LPY9970/VLC_FPGA_Project/05_data/02_Ref_and_Measured/Oscilloscope_Waveforms.jpg

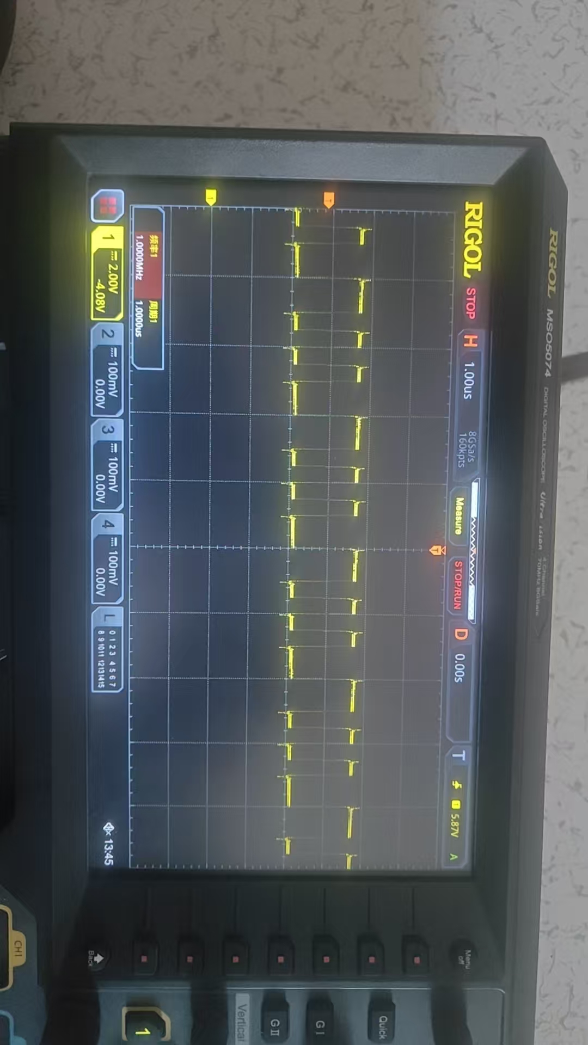
05_data/02_Ref_and_Measured/Oscilloscope_Waveforms.jpg
