LPY9970/VLC_FPGA_Project/05_data/02_Ref_and_Measured/Serial_Output_Photos.jpg

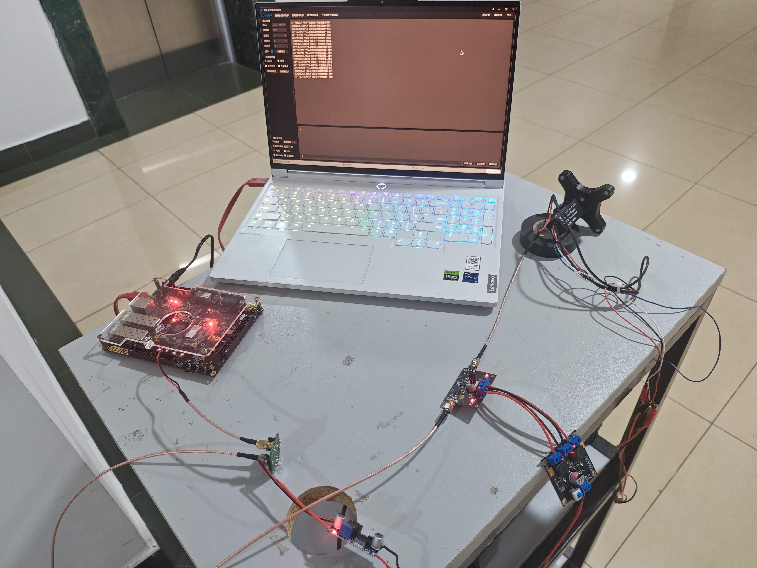
05_data/02_Ref_and_Measured/Serial_Output_Photos.jpg
