LPY9970/VLC_FPGA_Project/05_data/README.md

# 测试数据与参考结果验证报告 (VLC 光通信系统)

## 一、 测试目的
验证 VLC 空间光通信系统的完整链路（PC-UART -> PWM调制 -> 光发射 -> 20m空间光路 -> 光接收 -> PWM解调 -> UART-PC）的稳定性与正确性，并验证数据在长距离传输下是否发生丢包或误码。

## 二、 测试环境与数据
*   **物理环境**：20米自由空间光通信链路（使用透镜聚光与激光发射模块，见实物图）。
*   **上位机端**：PC 机，串口助手软件（波特率 9600, 8-N-1）。
*   **输入激励**：通过 PC 端串口发送 38 字节文本 “2017至2026 FPGA创新设计竞赛国赛十周年”。
*   **数据编码**：文本采用 GBK 编码（如 '2' 为 `0x32`，'0' 为 `0x30`）。
*   **物理层数据率**：1 Mbps。
*   **物理层编码**：采用 **PWM（脉宽调制）**。每 bit 周期固定为 1us，通过高电平脉宽区分数据：
    *   逻辑 `1`：高脉冲宽约 500ns（占空比 50%）。
    *   逻辑 `0`：高脉冲宽约 240ns（占空比 24%）。

## 三、 参考结果 (Reference Results)
根据系统设计逻辑，应输出以下参考结果：
1.  **发射端波形参考**：在 FPGA 的 `K14` 引脚，示波器应捕获到周期严格为 1us 的方波序列，且能清晰观察到宽脉冲（500ns）与窄脉冲（240ns）交替。
2.  **接收端输出参考**：在 PC 端串口助手上，应完整显示输入的那段 38 字节文本，不可出现乱码、丢字或卡死。

## 四、 实测结果与参考比对 (Measured vs. Reference)

### 1. 波形比对 (物理层验证)
*   **实测现象**：见 `board/01_Test_Output/Waveforms/Oscilloscope_PWM_Wave.png`。
*   **结果分析**：示波器实测周期为 **1.0000MHz**（即 1us），波形清晰展示了不同宽度的高脉冲。实测脉宽与理论设计的 500ns/240ns 高度吻合，证明 1Mbps PWM 调制逻辑完全正常。

### 2. 物理环境实测 (系统级验证)
*   **实测现象**：见 `board/01_Test_Output/Environment/Hardware_Setup_20m_Test.jpg`。
*   **结果分析**：系统在 20 米物理空间光路下成功建立连接，接收端光模块成功将光信号转化为电信号并正确解调。

### 3. 数据比对 (应用层验证)
*   **实测现象**：见 `board/01_Test_Output/Serial_Logs/Serial_Output_Verify.png`。
*   **结果分析**：PC 端串口助手成功、连续地复现了整段中文文本，与原始输入数据（`data/input_text.txt`）经人工与机器双重比对，完全一致，误码率为 0。

### 4. 极限吞吐测试 (压力测试)
*   **测试方法**：将发送端光信号回环短接至接收端（或保持 20m 光路），连续发送 100,000 字节。
*   **结果分析**：长时间运行下，接收端 FIFO 水位稳定，未发生溢出，实测丢包率为 **0%**，证明系统收发速率匹配（9600bps 串口收发）且逻辑稳定可靠。

## 五、 结论
系统的 PWM 调制解调逻辑正确，在 20m 物理光路下传输稳定。测试数据与参考结果完全一致，无丢包、无误码，满足了比赛/项目的设计要求。
