LPY9970/VLC_FPGA_Project/02_sim/PBRS/sim_picture_PBRS/屏幕截图 2026-11-02 062121.png

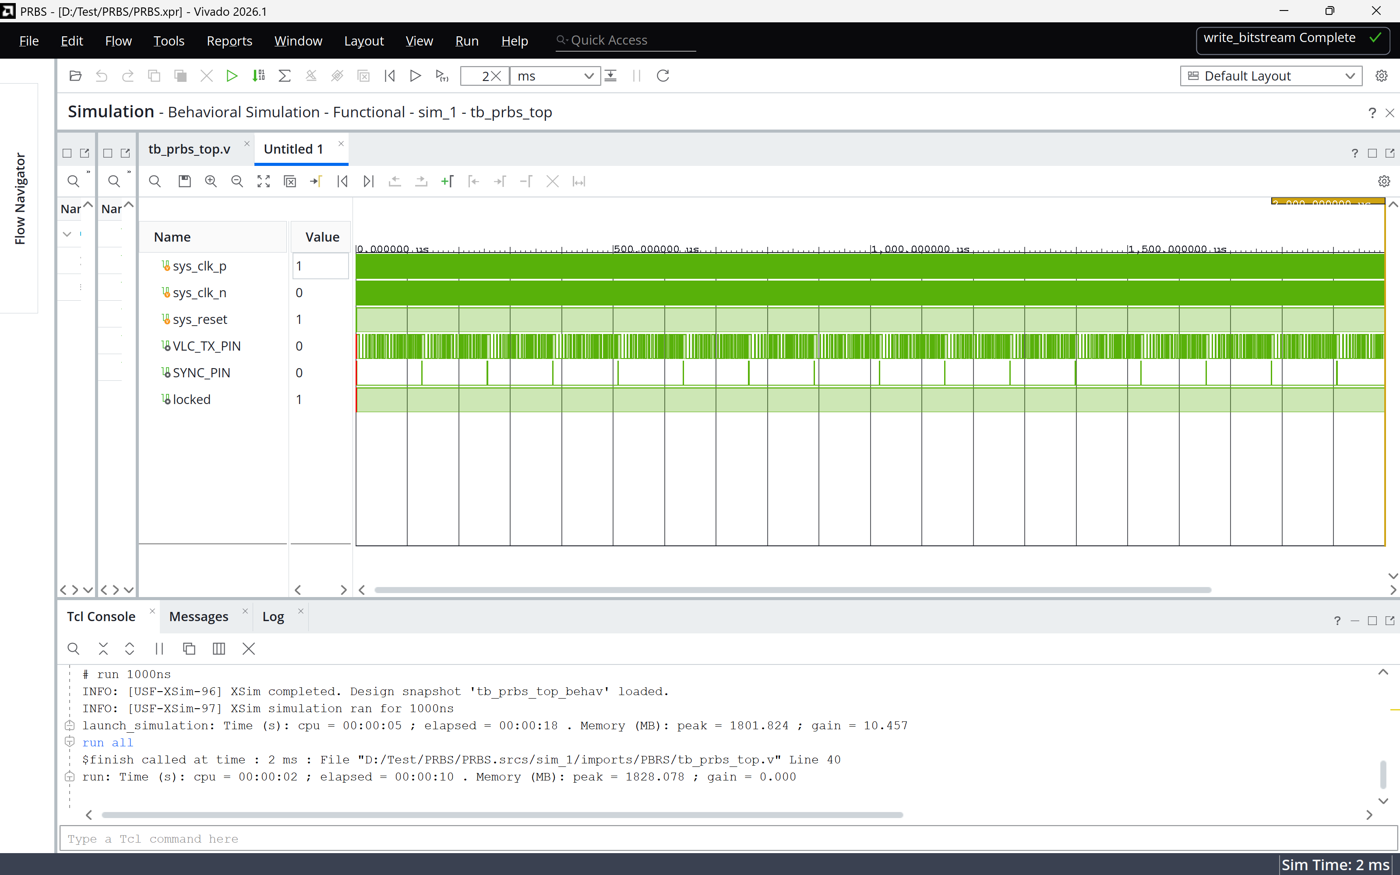
02_sim/PBRS/sim_picture_PBRS/屏幕截图 2026-11-02 062121.png
