LPY9970/VLC_FPGA_Project/02_sim/PBRS/sim_picture_PBRS/屏幕截图 2026-11-03 035135.png

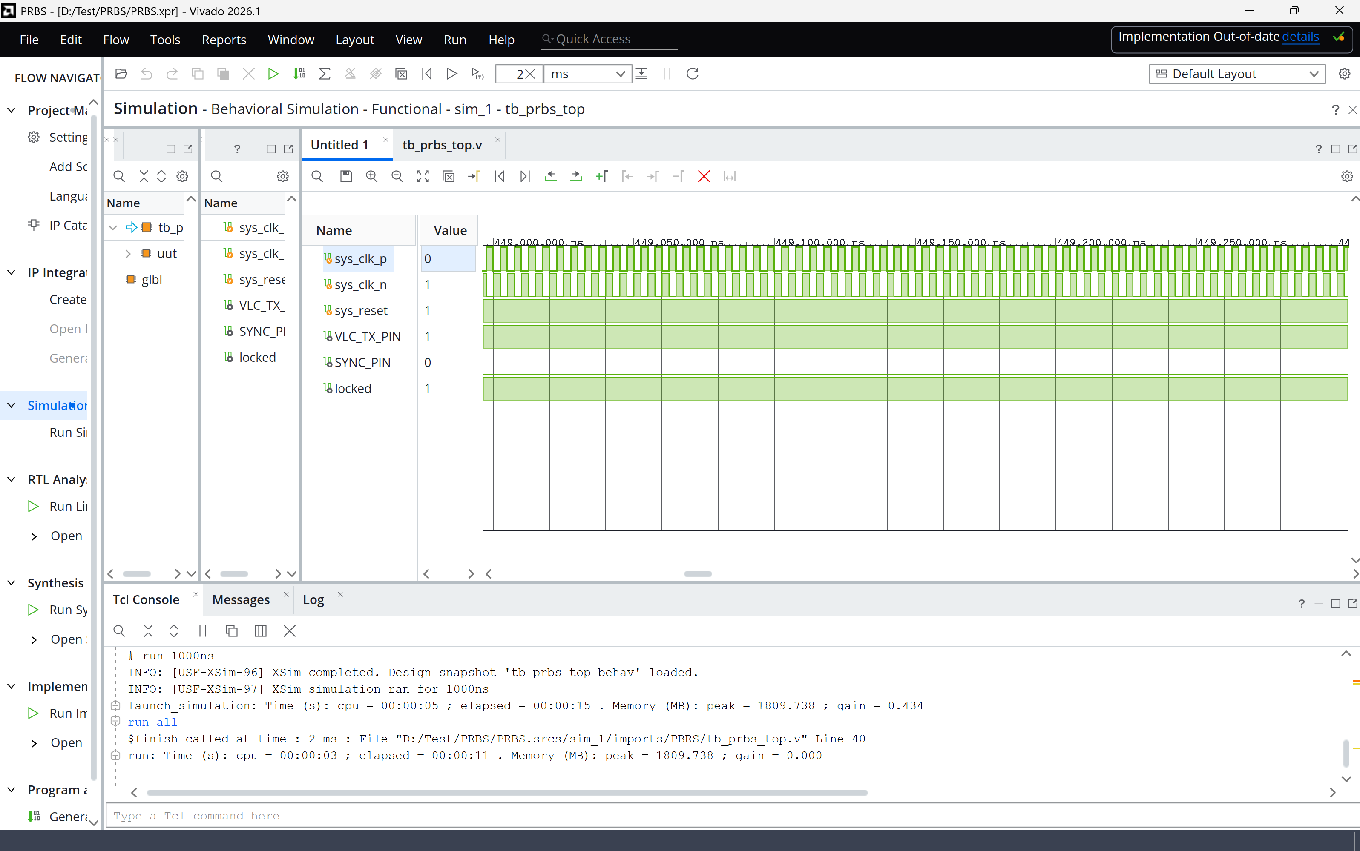
02_sim/PBRS/sim_picture_PBRS/屏幕截图 2026-11-03 035135.png
