LPY9970/VLC_FPGA_Project/02_sim/RX/sim_picture_rx/屏幕截图 2026-11-02 071604.png

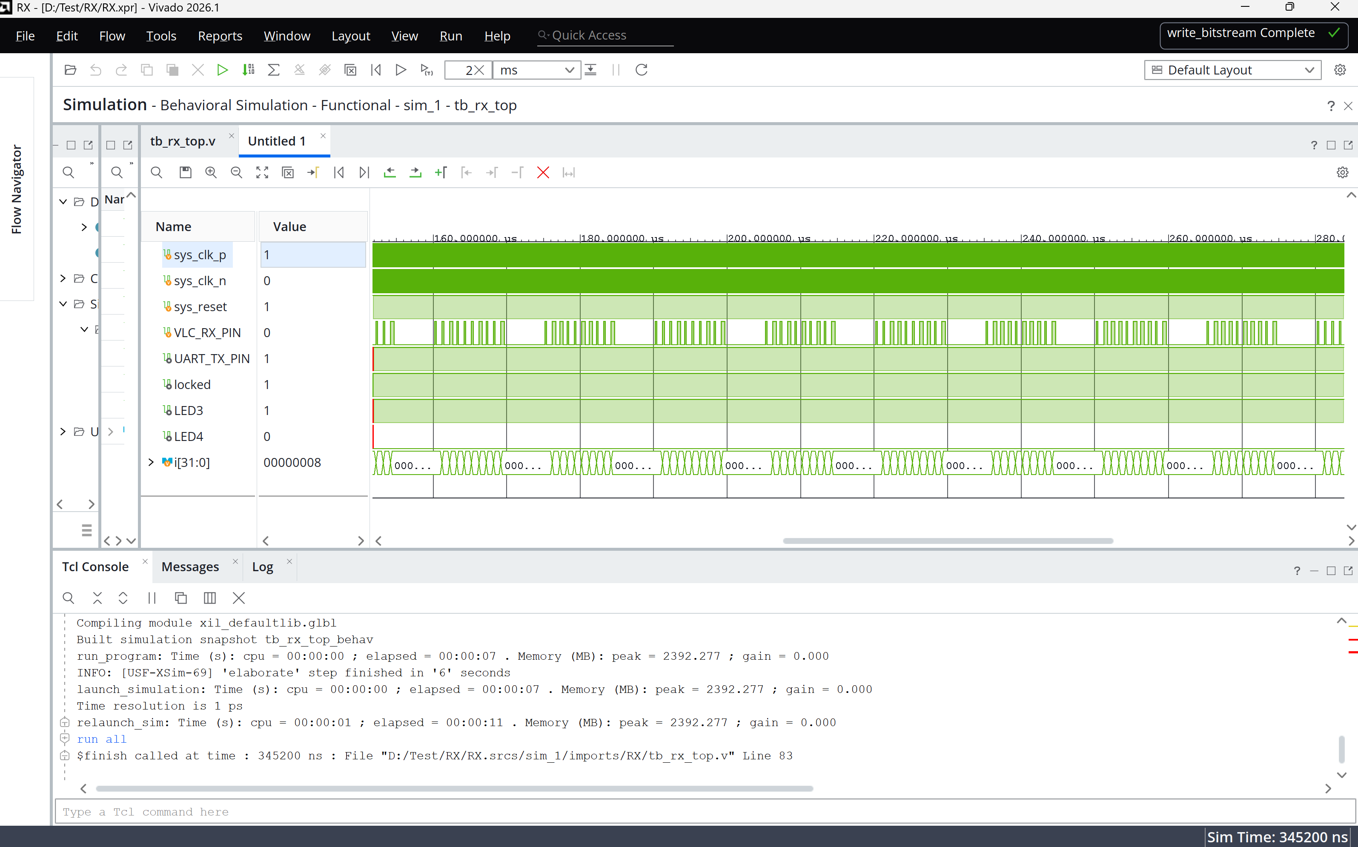
02_sim/RX/sim_picture_rx/屏幕截图 2026-11-02 071604.png
