LPY9970/VLC_FPGA_Project/02_sim/TX/sim_picture_tx/屏幕截图 2026-11-02 054549.png

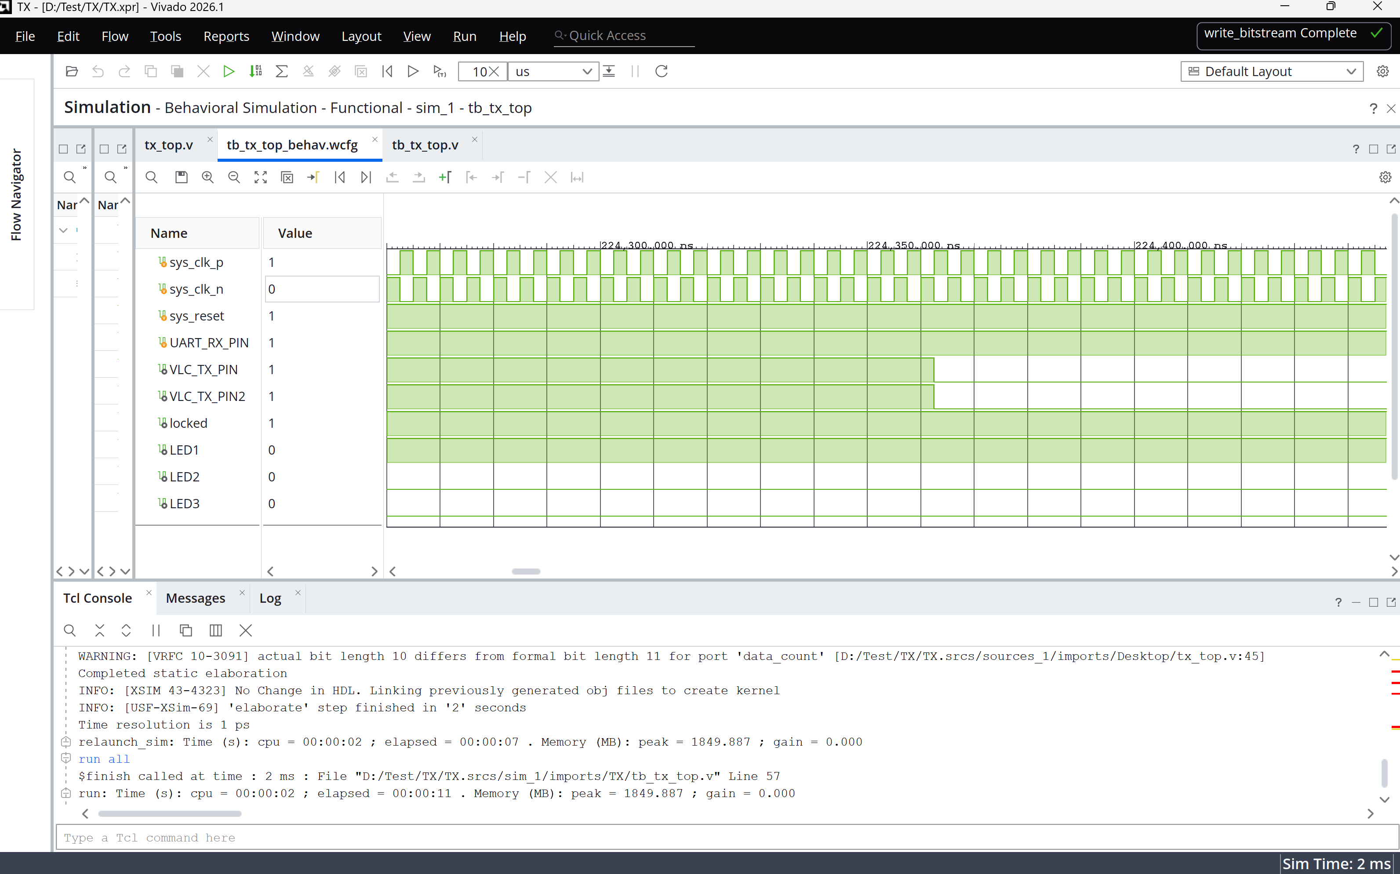
02_sim/TX/sim_picture_tx/屏幕截图 2026-11-02 054549.png
