LPY9970/VLC_FPGA_Project/04_board/Screenshots/接收发送测试文字图.jpg

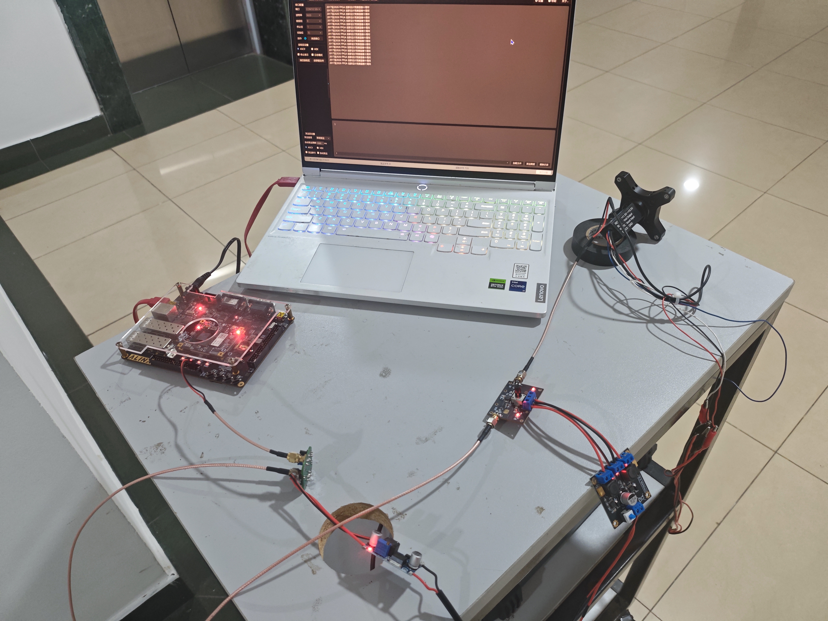
04_board/Screenshots/接收发送测试文字图.jpg
